jdbodyfelt/rockboard-quickmount/JOSH_TODOS.md

# Josh's TODOs

1. Get a number of measurements on Whammy IV. Need to keep feet in place and put in "edge-finger mounts".

2. Establish layout on the Timeline. Likely a joined baseplate with a small angle riser for the main unit while Multiswitch remains flat.
Concerned about easy all-button access.

3. Revisit Modelers - check board placement, may require a riser state. Also may consider a funky "battery lock" that uses the battery compartment to hold the board in place. Need to check if this is feasible with the current battery compartment design.

4. Order all rebuild kits for the modelers. Contact EE departments for any students requiring a build project. Look at board assembly businesses - those ones over on William Pickering Dr. They may be able to do solder reflow (has SMT components).
