jdbodyfelt/rockboard-quickmount/docs/inventory.md

# Equipment inventory

Physical items available for measurement, and how each may be used. Update this file whenever an item is added, borrowed, or destroyed.

Last updated: 2026-10-21.

## 1. Board

| Item | Detail | Status |
| --- | --- | --- |
| RockBoard **Cinque 5.2** | 622 x 424 mm, 3.95 kg (Official envelope) | Available |

Model is confirmed as **Cinque 5.2**. The table below is retained for reference if a second board is ever added:

| Model | Width | Depth |
| --- | --- | --- |
| Quad 4.1 | 470 mm | 330 mm |
| Quad 4.2 | 622 mm | 330 mm |
| Quad 4.3 | 828 mm | 330 mm |
| Quad 4.4 | 722 mm | 330 mm |

A 622 mm width identifies 4.2; 722 mm identifies 4.4. Record the confirmed model in the board profile and in [rockboard-system.md](rockboard-system.md).

## 2. OEM QuickMount plates

Plate types are inferred from RockBoard's compatibility lists and must be confirmed from the part number moulded on the underside.

| Plate for | Expected type | Product no. | Qty | Capture method |
| --- | --- | --- | --- | --- |
| BOSS OC-2 | Type E (BOSS compact) | RBO B QM T E | 2 (with OD-3) | Non-destructive |
| BOSS OD-3 | Type E (BOSS compact) | RBO B QM T E | (second unit) | Non-destructive |
| Wah pedal | Type M (Dunlop Cry Baby standard) | RBO B QM T M | 1 | Non-destructive |
| Strymon Timeline | Type J1 (BOSS 500-series / Strymon large-format) | RBO B QM T J1 | 1 | Non-destructive |

**No plate may be cut, sawn, or otherwise damaged.** All four plates stay usable. The second Type E is valuable as a repeatability check, not as a sacrificial sample: measuring both tells us whether the moulded geometry is consistent.

Capture techniques, in order of preference:

1. Callipers (inside and outside jaws) and micrometer on every accessible external feature.
2. Paper rub with a known reference for flat outlines, hole centres, and pitch.
3. Macro photography with a steel rule in the same plane; digitise outlines and contact points.
4. Two-part silicone mould putty pressed onto the keeper cavity (peels off cleanly, no residue) and cast in rigid resin.
5. Borrowed or commercial CT/X-ray scanning if internal geometry remains ambiguous.
6. OEM drawings or replacement-part dimensions, if RockBoard will share them.

Confirm each type by looking for the moulded product number (format `RBO B QM T <type>`) on the plate's underside.

## 3. Pedals

| Pedal | Housing | Use in the project |
| --- | --- | --- |
| BOSS OC-2 | BOSS compact | Screw-pattern measurement; compares directly with the Type E plate |
| BOSS OD-3 | BOSS compact | Second Type E sample; confirms batch consistency |
| Dunlop wah (model TBC) | Wah housing | Screw pattern for the Type M plate |
| Strymon Timeline | Large-format Strymon | Screw pattern for the Type J1 plate |

The two BOSS compact pedals give a useful repeatability check: if the same plate fits both, the Type E hole pattern covers the family's variation.

## 4. Gaps

| Missing item | Impact | When needed |
| --- | --- | --- |
| Duo, Tres, or Cinque board | Cannot confirm the slot grid is common across families | Phase 3 (or earlier if borrowed) |
| Internal view of the keeper | External measurement may leave the latch kinematics ambiguous | Phase 1, if silicone impressions are inconclusive |
| Spare Type M and J1 plates | No repeatability check for those types | Optional; do not buy solely for measurement |

## 5. First measurement session

Order of work, using only what is on hand. Budget roughly half a day. The metrology kit is complete: caliper (inside/outside jaws), micrometer, tape, feeler gauges, silicone putty, spring/luggage scale, and 0.1 g scale.

1. **Identify the board model** by width; photograph the label and a slot close-up.
2. **Measure the board** with the `B-01` to `B-10` record in [geometry-capture.md](geometry-capture.md#31-board-measurement-record): slot width, length, end radius, rib width, pitch, sheet thickness, powder coat, plane angle, under-sheet clearance.
3. **Measure both Type E plates** (`Q-01` to `Q-10`) and compare them for repeatability. Capture the keeper cavity with a silicone impression if putty is available.
4. **Photograph and measure the BOSS compact pedals** (OC-2, OD-3): footprint, height, weight, screw positions, thread, depth.
5. **Measure Type M and J1** with callipers, photography, and silicone impressions. All plates remain intact.
6. **Record the OEM baseline** (insertion, release, pull-off, 100 cycles, creep at 50 °C and 70 °C) using the Type E plate in the Cinque 5.2.
7. File the records and photos under `docs/measurements/<date>/`.

## 6. Handling notes

- Do not cut, saw, or heat any plate. The set is complete and must stay serviceable.
- Use the QuickRelease Tool to remove plates; do not lever them out with a screwdriver.
- Photograph every part before disassembly so hole positions and orientation are recoverable.
- Silicone putty impressions are one-use and leave no residue; take them after the calliper record is complete.
- Store each plate in a labelled bag with its measurement ID when not mounted.

## 7. Related documents

- Measurement procedure: [geometry-capture.md](geometry-capture.md)
- Board parameters: [rockboard-system.md](rockboard-system.md#5-parameters-we-must-measure)
- OEM plate types: [quickmount-system.md](quickmount-system.md#2-product-range-official)
