jdbodyfelt/rockboard-quickmount/125B_quickmount.stl

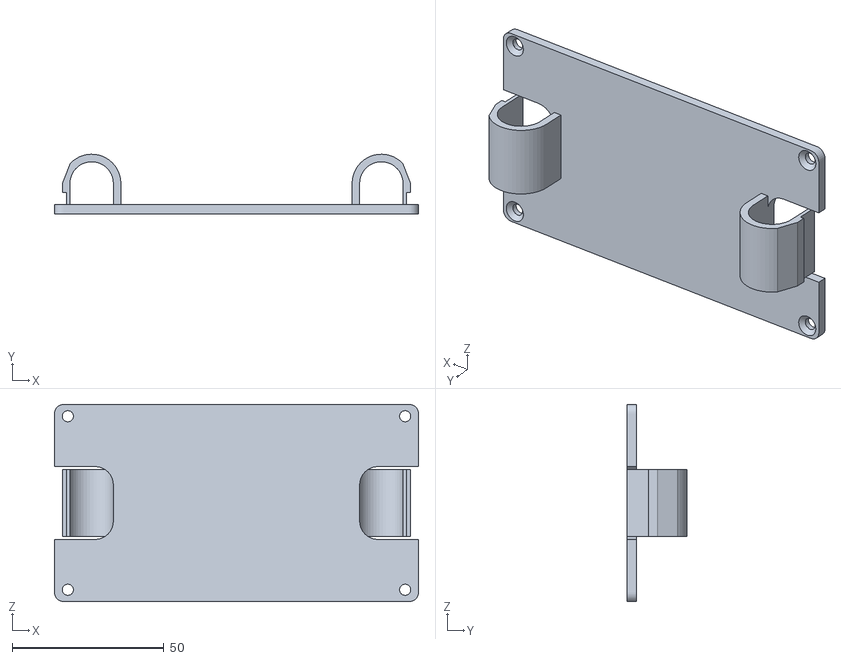
[picture p1: CAD file, 2026-11-03]
125B_quickmount.stl
120.0 x 19.6 x 65.0
