jdbodyfelt/rockboard-quickmount/catalog/printers/kea_petg.yaml

# Kea Modelling PETG profile - clearance values are starting estimates

id: kea_petg
vendor: kea_modelling
material: PETG
validated: false
clearance:
  barb_slide_mm: 0.25      # per side, barb to slot edge during insertion
  barb_latch_mm: 0.35      # barb locking face to sheet underside
  screw_hole_mm: 3.8       # through hole, accepts M3 and M3.5 countersunk
  counterbore_extra_mm: 0.2
