jdbodyfelt/rockboard-quickmount/(commit log)

2026-10-21 Add preparation docs and staged plan for custom QuickMount plates
    - docs/: board geometry, QuickMount mechanics, metrology procedure, pedal data model, rendering pipeline, input schema, and sources
    - PLAN.md: phased plan from pedal input to printable STLs, with gates, risks, and required decisions
    - README: project overview, status, and links
2026-10-21 Add Kea Modelling manufacturer profile and PETG design constraints
    - docs/manufacturing.md: vendor capability, PETG decision, FDM design rules, vendor calibration coupon, ordering workflow, consultation questions, vendor risks
    - PLAN: Phase 0 manufacturer decision, Phase 1 vendor coupon and orientation A/B, PETG creep at 50/70 C, new vendor risks and decisions
    - Align pipeline profiles, metrology, QuickMount constraints, schema, sources, and README with the Kea/PETG target
2026-10-21 Mark Kea engagement as enquiry-only and defer ordering
    - manufacturing.md: record enquiry status and add a response log for vendor answers
    - PLAN: vendor questions sent is the Phase 0 step; calibration coupon ordering waits on answers
2026-10-21 Record owned Quad board and OEM plates; scope Phase 1 measurements
    - inventory.md: board, Type E x2, Type M, Type J1, pedal list, destructive-test policy, first session plan
    - PLAN: Phase 1 uses the on-hand plates; second board family moves to Phase 3
2026-10-21 Switch plate capture to non-destructive methods only
    - inventory: all four OEM plates remain intact; Type E pair is a repeatability check, not a sacrificial sample
    - geometry-capture: silicone impressions instead of sectioning, powder-coat method without cutting, owned micrometer/tape noted
    - PLAN: remove sectioning and plate purchases; add risk R17 for unresolved internal geometry
2026-10-21 Mark metrology kit complete
    - geometry-capture: feeler gauges, silicone putty, luggage scale, 0.1 g scale, and camera marked owned; only optional radius/thread aids remain
    - inventory and PLAN: no measurement purchases left for Phase 1
2026-11-01 Add parametric plate generator and first-order STLs for Tumnus Deluxe and Mira
    - docs/quickmount-mechanism.md: mesh analysis of the published clip set (tab/rib engagement, wall gaps, barbs), OEM inference, chosen slide-latch design, provisional board dims, print orientation
    - docs/screws.md: M3.5 vs M3 analysis from the 6.5 mm head OD, AliExpress order list
    - quickmount/: build123d generator (plate, hooks, countersinks), analytic engagement validation, STL/STEP/manifest export
    - catalog/: board profile (provisional), pedal records, Kea PETG profile; tools/: STL measurement utilities
    - reference models are CC BY-NC-SA and are git-ignored; only measurements were carried forward
    Co-authore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
2026-11-01 Replace slide-latch with C-shaped snap keepers
    Each keeper is now a pair of mirrored C flexures: rooted at the plate, through a U-bend in the board void, rising to a barb that snaps under the sheet.
    - 45 deg ramp cams the free end inward 1.2 mm on insertion; the shelf then bears on the sheet underside (positive lock, 0.3 mm clearance)
    - 18.5 mm developed flexure length keeps peak strain at 0.95 % against a 1.5 % PETG limit
    - 3.1 mm release gap between neck and branch so the flexures can be pinched from under the board
    - validator: 14 analytic checks including strain, squeeze, ledge, release gap, keeper depth in the board void
    - docs: mechanism section and print orientation rewritten for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
    [build.py, validate.py]
2026-11-01 Reproduce the measured reference clip; correct board to Cinque 5.2
    The previous slide-latch and C-flexure parts were wrong. Rebuilt around the actual mechanism.
    - catalog/clips/reference_2space_clip.yaml: measured cross-section of the reference clip, with provenance
    - quickmount/clip.py: exact replica (69.0 x 16.0 x 19.64 mm, 0.6% volume match) plus a baseplate that absorbs the 3.00 mm bar and carries the same hook section
    - board corrected to Cinque 5.2 (622 x 424 mm); Quad profile removed
    - docs: mechanism section rewritten from measurement; orientation ambiguity documented
    [build.py, cinque_5_2.yaml, validate.py]
2026-11-01 Reduce scope to keeper rings and arrangements
    Pedal-specific baseplates for the Tumnus Deluxe and Mira are removed; both are
    vertical 125B and both take OEM Type B1, recorded as housing data for later.
    - quickmount/keeper.py: ring cut from the measured section; arrangements place N rings one pitch apart with bar_len = pitch*(n-1)+post_t
    - outputs: keeper_ring (18.3 x 16 x 19.64), 2-ring (69.1 mm, matches the 69.0 mm reference within 0.1), 3-ring
    - docs and README scoped to the mechanism; screws and pedal schema marked deferred
2026-11-01 Set slot grid from the official drawing: 17.7 slot, 16 rib, 33.7 pitch
    - rib width 16 mm read from the dimensioned gap between adjacent slots on the Cinque 5.4 technical drawing
    - pitch derived as slot + rib = 33.7, corroborated by the reference clip's 32.90 mm hook spacing within 0.8 mm
    - new check: arch span 16.8 must clear the rib so the skirt enters the next slot (+0.8 mm)
    - ring clearance 0.85/side flagged as a warning; ring_width parameterised
    - docs: drawing provenance, and a note that the four cinque_54_00*.pdf files are retailer pages
    [cinque_5_2.yaml, keeper.py, validate.py]
2026-11-01 Fix stale anchor to the board dimensions section
2026-11-02 Size the arch against the measured rib range
    - rib measured 16.3-16.8 mm over powder coat; drawing's 16 mm is the bare-metal punch-out. Coated numbers govern.
    - pitch now derived as 34.0-34.5 (nominal 34.25); the reference clip's 32.90 hook spacing is 1.1-1.6 mm short
    - reference arch span 16.8 equals the worst-case rib, leaving zero margin: arch scaled 1.0714 about the post outer face to an 18.0 mm span (1.2 mm skirt intrusion)
    - validator: intrusion at worst-case rib, skirt still in slot at smallest rib, pitch tolerance vs slot slack
    [build.py, cinque_5_2.yaml, keeper.py, validate.py]
2026-11-02 Confirm the lip-clamp mechanism and size the ring to the slot
    The C-shape presses a lip against the slot edge; release needs a flat blade. Retention is therefore lateral spring pressure, which the reference part's 16.0 mm width cannot provide in a 17.7 mm slot.
    - ring width now slot - 0.3 (17.4 mm), parameterised via --ring-width; reference 16.0 available for fidelity
    - validator: ring must reach the slot edge (0.1-0.5 mm total clearance) instead of merely fitting
    - docs: mechanism confirmed from the undercarriage photos; orientation question replaced by a preload question
    [build.py, keeper.py, validate.py]
2026-11-02 Define under-sheet clearance precisely and add brace spacing
    [cinque_5_2.yaml]
2026-11-02 Record the 3.0 mm sheet and re-read the lip mechanism
    At 3.0 mm the sheet cannot be clamped between the bar and the 1.82 mm inner skirt tip, so that tip must bear laterally on the slot wall - which agrees with the undercarriage evidence.
    - board: aluminium 3.0 + coat 0.1; sheet thickness now measured
    - clip: arch_base_depth 10.0 mm recorded; new checks for arch clearing the sheet and ring depth below the sheet (16.5 mm)
    - docs: 3.2 rewritten, open items reduced to lip preload and under-sheet clearance
    [cinque_5_2.yaml, keeper.py, validate.py]
2026-11-02 Add component-based QuickMount builds
    Add reusable mount components, pedal configurations, and engraved branding with framed labels.
2026-11-02 Organize generated mount outputs
    Write keeper and pedal builds into named output folders and record out-relative paths in manifests.
2026-11-03 Add a 125B riser base derived from the measured plate
    The riser's resting surface is the 125B plate's own underside, so the base of the riser is the measured 125B mount reduced to a solid: mount holes cleared, brand stamp left off.
    ase_mount lets a config include another and override only what changes, so the 120 x 65 outline, R3 corners, 3.0 mm plate and two-clip spine stay tied to the part they were measured on. A null or empty value deliberately clears an inherited field.
2026-11-03 Add split-plate clip offsets, pedal-face pockets and a boundary export
    - SpineSpec.along_offset shifts a clip row along the spine axis, so a split
    plate can carry one clip per spine without moving it off the board grid.
    - Pocket.face picks the surface a blind pocket opens on: "pedal" recesses a
    stock rubber foot at z = 0, "board" keeps the previous clip-side behaviour.
    - build_boundary() returns the pedal-face silhouette alone; --boundary writes
    it as SVG and STEP so edge fingers can be laid out against the real outline.
    - Record the Cinque 5.4 board profile from the official drawing and the
    measured 5.2, and add the STL countersink tool used on the 125B riser,
    the resulting plate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
    [125B_quickmount.stl]
2026-11-03 Replace the Whammy IV draft with the measured Whammy V plate
    Rename the catalog entry and rebuild it from the owner's 2026-11-03
    measurements: a 165 x 197 mm footprint with square corners, the stock rubber
    feet kept in 2.8 mm blind recesses on the pedal face, and four clips on a
    3 x 34.0 mm rib pitch. The plate is flush to the board's lower and right edges,
    so the clip positions are measured rather than photo-estimated.
    Retention changes from plate screws to edge fingers bearing on the five
    hex-head side screws, and the 200 x 203.2 mm drawing's corner holes go away.
    docs/component-model.md now documents the new plate, the pocket semantics and
    the rib-phase question that still has to be sett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
    [digitech_whammy_v.yaml]
